pdtkelly/Explorer-HAT/RevA2/BOM/Explorer Board HAT Coupling Kit Rev A2 BOM.pdf

Item | Qty | Location (bottom ) | Mfg Part # | Description | Rating | Footprint | Mfg | Mouser | DigiKey | Notes | $ each | Total
| | | | Assemble Explorer HAT to Raspberry PI
1 | 4 | M1, M2, M3,M4 | 24423 | Hex Spacer M2.5 threaded Al 10mm | Keystone | NA | 36‐24423‐ND | 0.296 | 1.184
1 | | M1, M2, M3,M4 | 970090151 | Hex Spacer M2.5 threaded Al 9mm | Wurth | NA | 732‐10537‐ND | 0.422
3 | 8 | M1, M2, M3,M4 | 29300 | Screw Machine Pan M2.5 x 4mm | Keystone | 534‐29300 | 36‐29300‐ND | 0.237 | 1.896
5 | 0 | M1, M2, M3,M4 | 222 (Purple) | Threadlocker 222 tube 6 ml | Loctite | (on screw) | Amazon | 8.140 | 0.000

$3.08

1 | These components should be stocked due to concerns over lead time and/or limited substitutions available.
2 | Cut pins flush to this board (0.030 inch or less)
3 | Do not wash
4
5 | Leave holes open (do not fill with solder)
6 | Thru‐hole component
7

## Explorer Board HAT Coupling Kit PN: 1278 Rev A2

## As of: 10/26/2017 Patrick Kelly, Jack Kelly © Copyright 2017

Notes:

### Sub total:
