pdtkelly/Explorer-HAT/(threads)

Thread 11 (2019-01-01):

Drill holes.

kicker22004, 2019-01-01:
There is an issue in the Gerber files that don't allow the Drill holes to be detected by services like OSHPARK.
I've used this manufacture many times and had them correct the issue for me. Can you please look into this as it's a problem in the zwire_b.DRL file format.

This is a link to the corrected file format.
https://pastebin.com/JhBMNmCX
