pdtkelly/Explorer-HAT/RevA2/Schematic/Explorer Board HAT Rev A2 Schematic.pdf

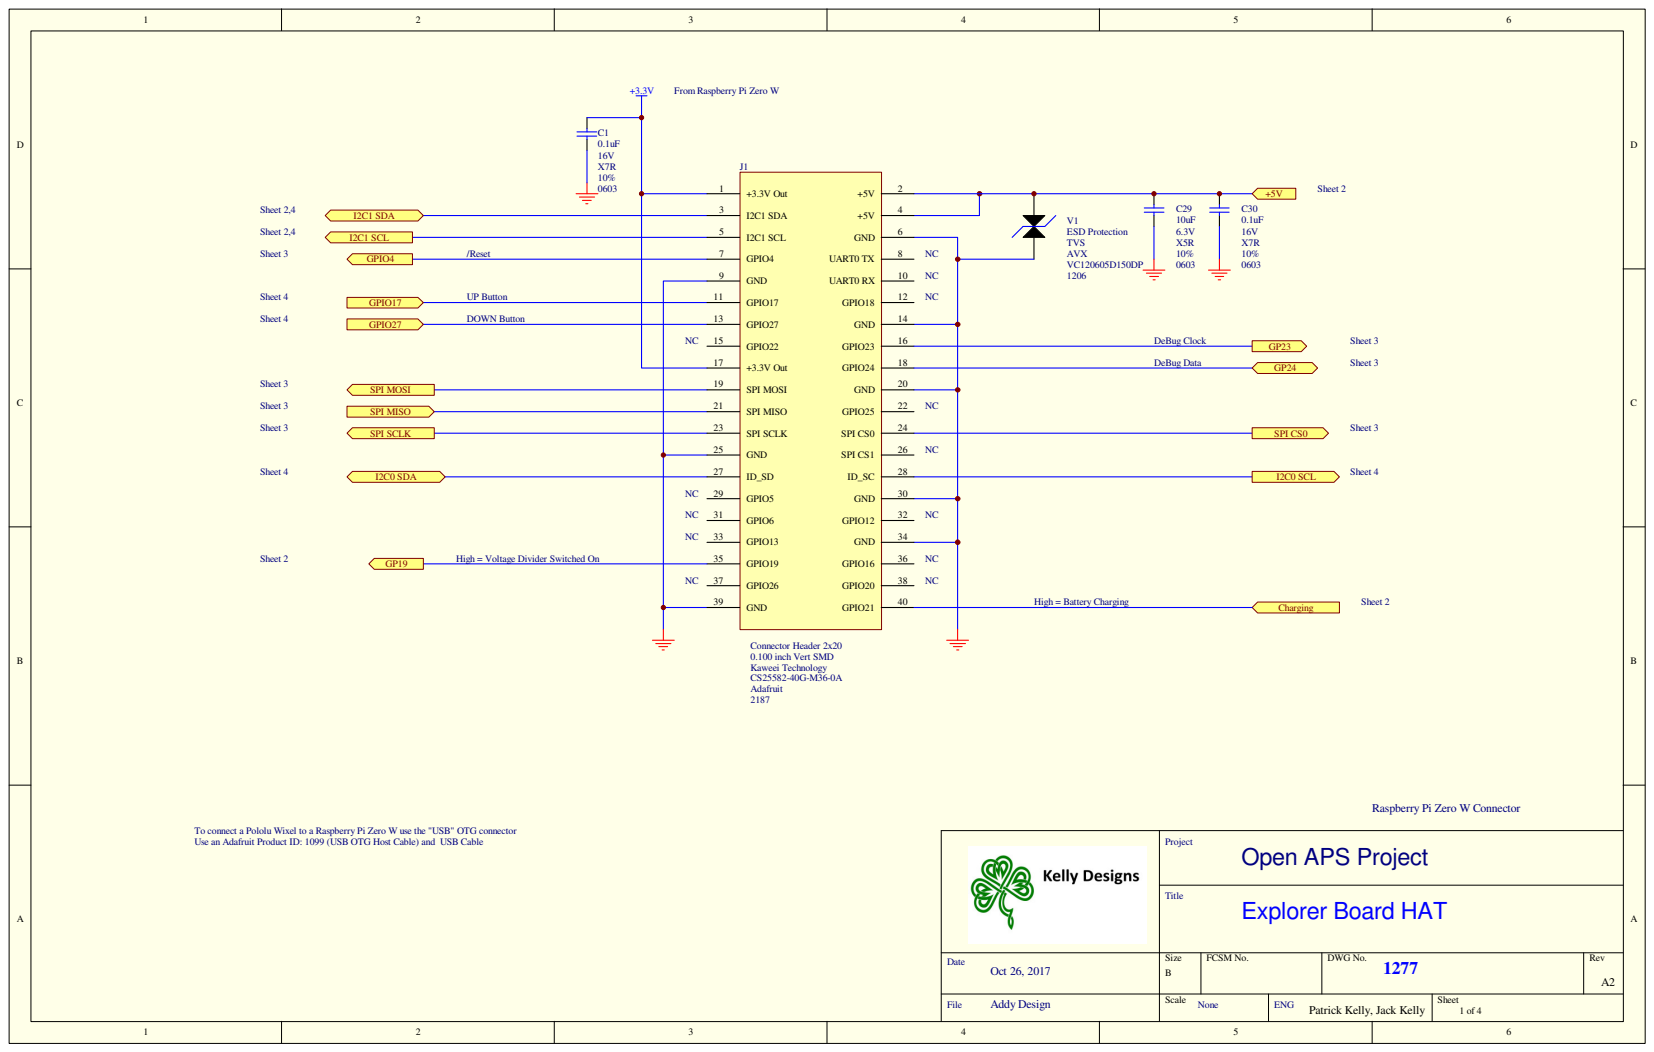
[picture p31: page 1]
Scale; Sheet; Size; FCSM No.; DWG No.; Rev; None; ENG; Project; Title; Date; File; Oct 26, 2017; Addy Design; Connector Header 2x20 0.100 inch Vert SMD Kaweei Technology CS25582-40G-M36-0A; From Raspberry Pi Zero W; I2C1 SDA; I2C1 SCL; Sheet 2; Sheet 2,4; GPIO4; GPIO17; GPIO27; SPI MOSI; SPI MISO; SPI SCLK; SPI CS0; Sheet 3; Sheet 4; I2C0 SDA; I2C0 SCL Sheet 4; +3.3V Out 1; I2C1 SDA 3; I2C1 SCL 5; GND; GPIO4 7; UART0 TX; GND 9; UART0 RX; GPIO17 11; GPIO18; GPIO27 13; GPIO22 15; GPIO23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

Raspberry Pi Zero W Connector

To connect a Pololu Wixel to a Raspberry Pi Zero W use the "USB" OTG connector
Use an Adafruit Product ID: 1099 (USB OTG Host Cable) and USB Cable

Open APS Project

Explorer Board HAT

Patrick Kelly, Jack Kelly

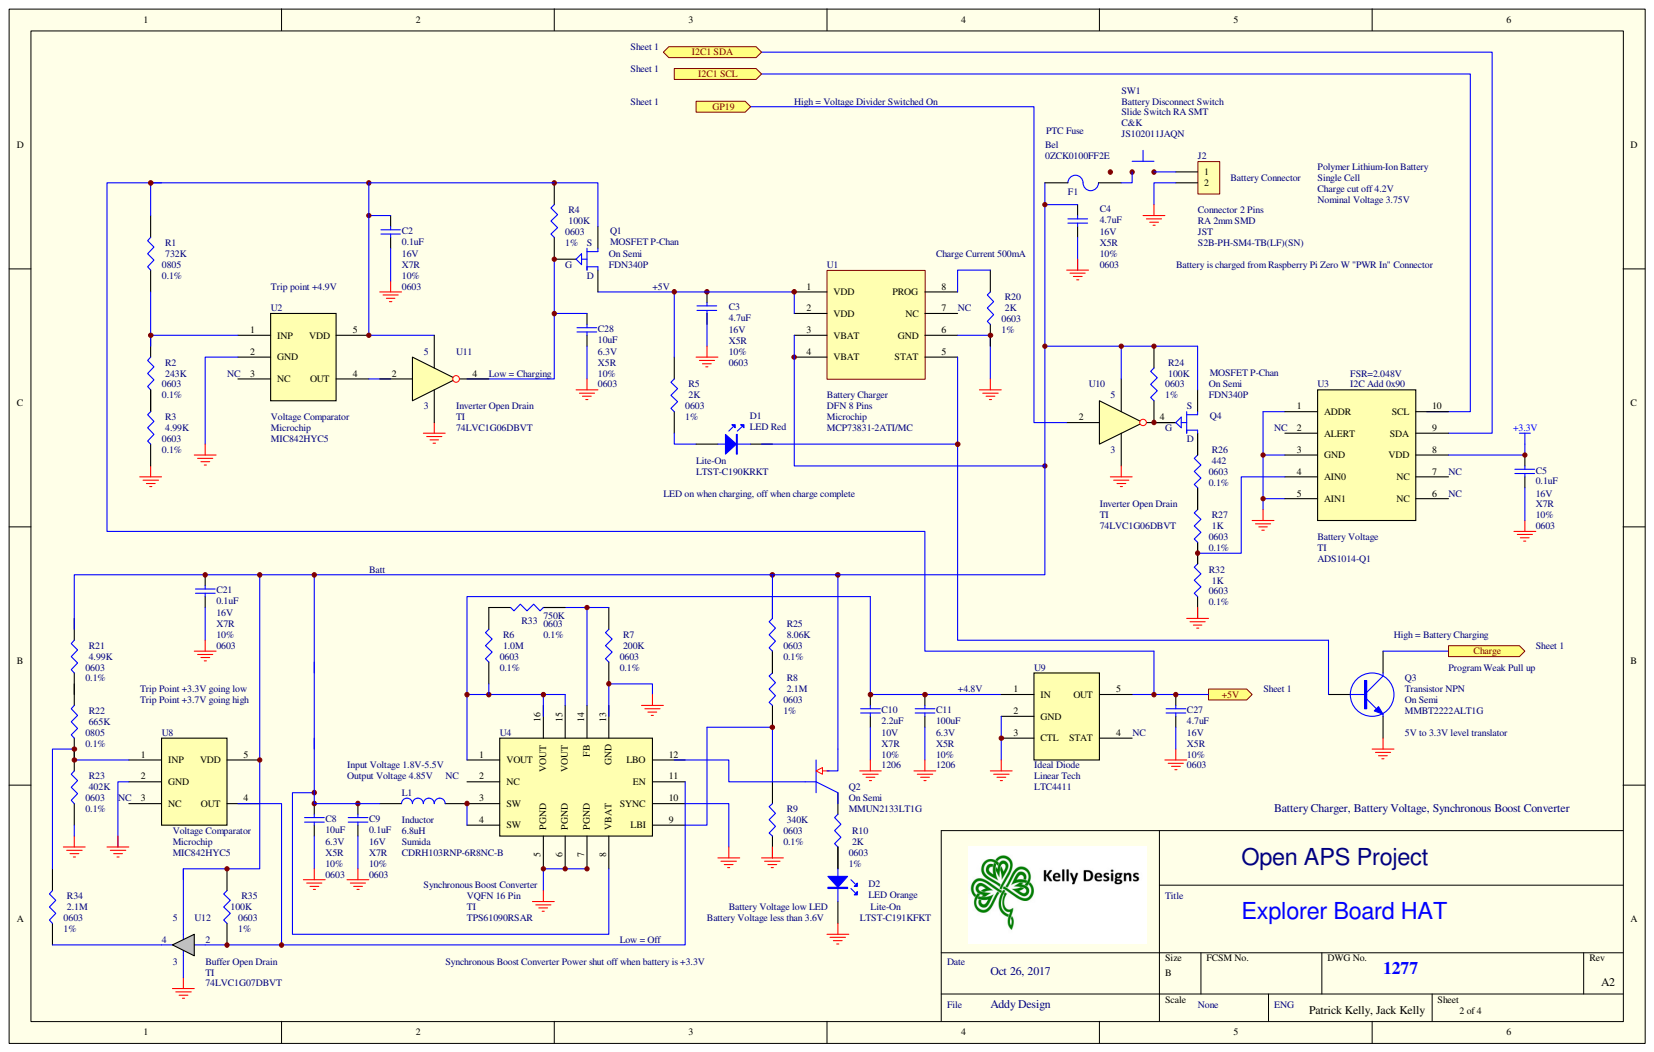
[picture p32: page 2]

High = Voltage Divider Switched On

Polymer Lithium-Ion Battery
Single Cell
Charge cut off 4.2V
Nominal Voltage 3.75V

Connector 2 Pins
RA 2mm SMD
JST

LED on when charging, off when charge complete

Program Weak Pull up

Trip Point +3.3V going low
Trip Point +3.7V going high

Battery Charger, Battery Voltage, Synchronous Boost Converter

Battery Voltage low LED
Battery Voltage less than 3.6V

Synchronous Boost Converter Power shut off when battery is +3.3V

Patrick Kelly, Jack Kelly

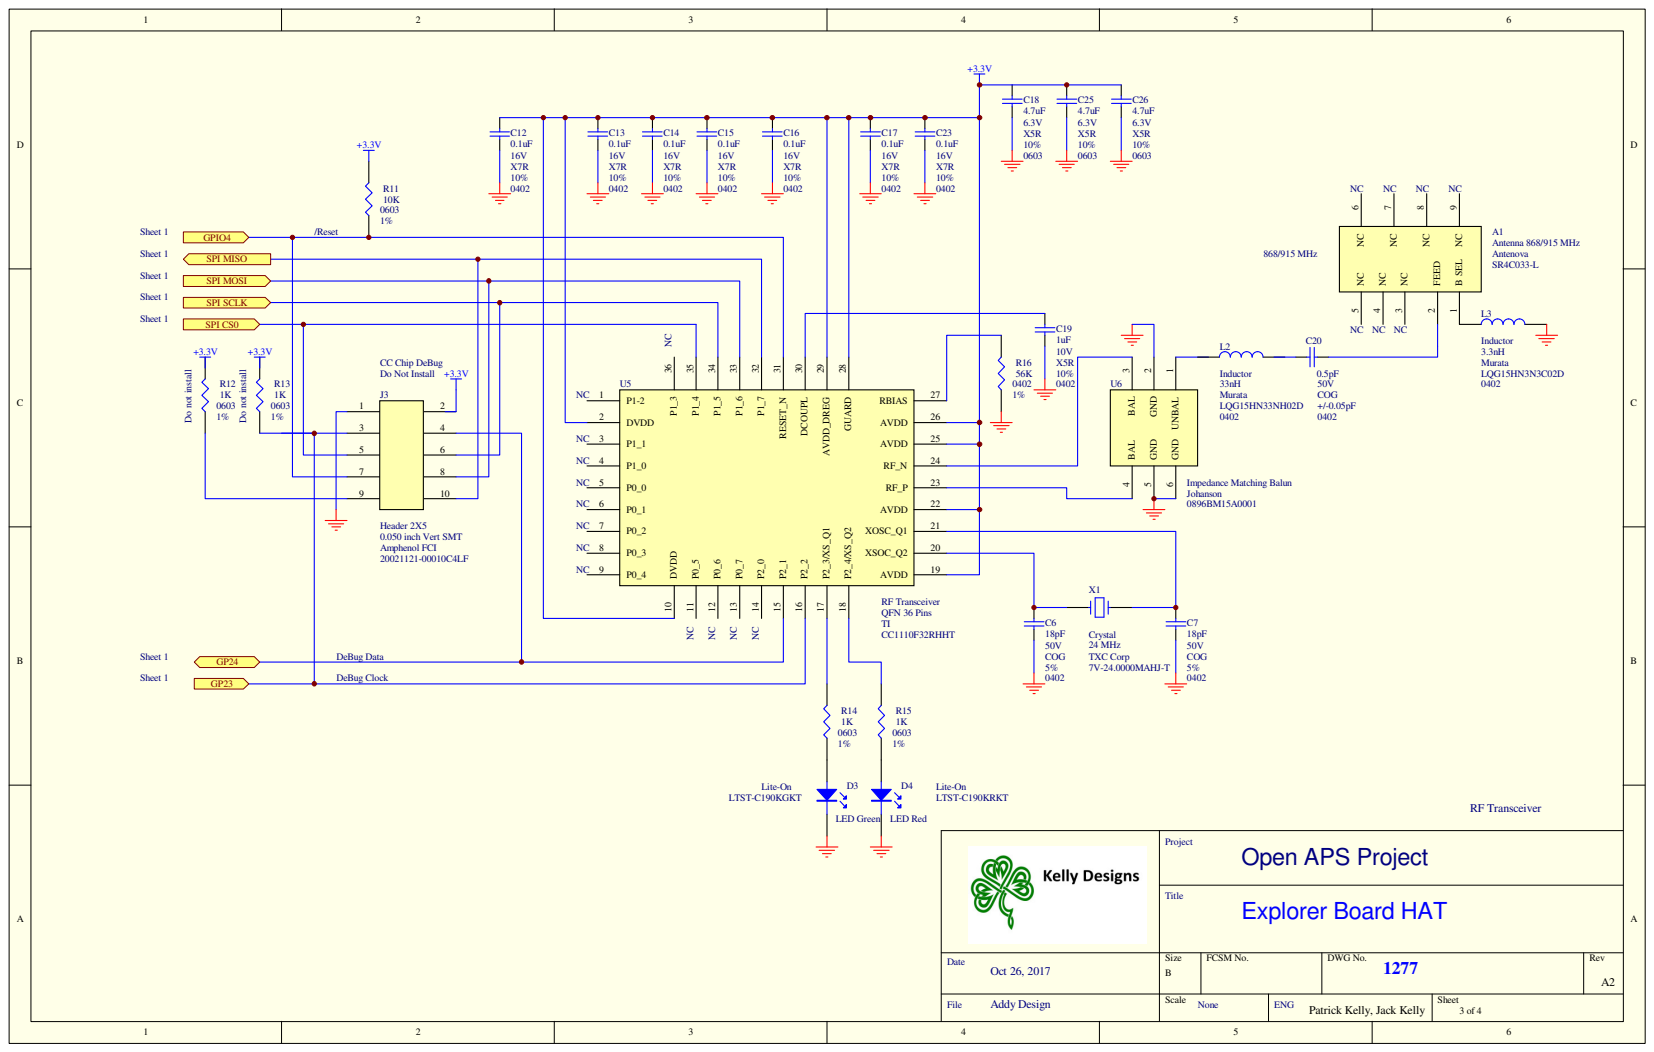
[picture p33: page 3]

Patrick Kelly, Jack Kelly

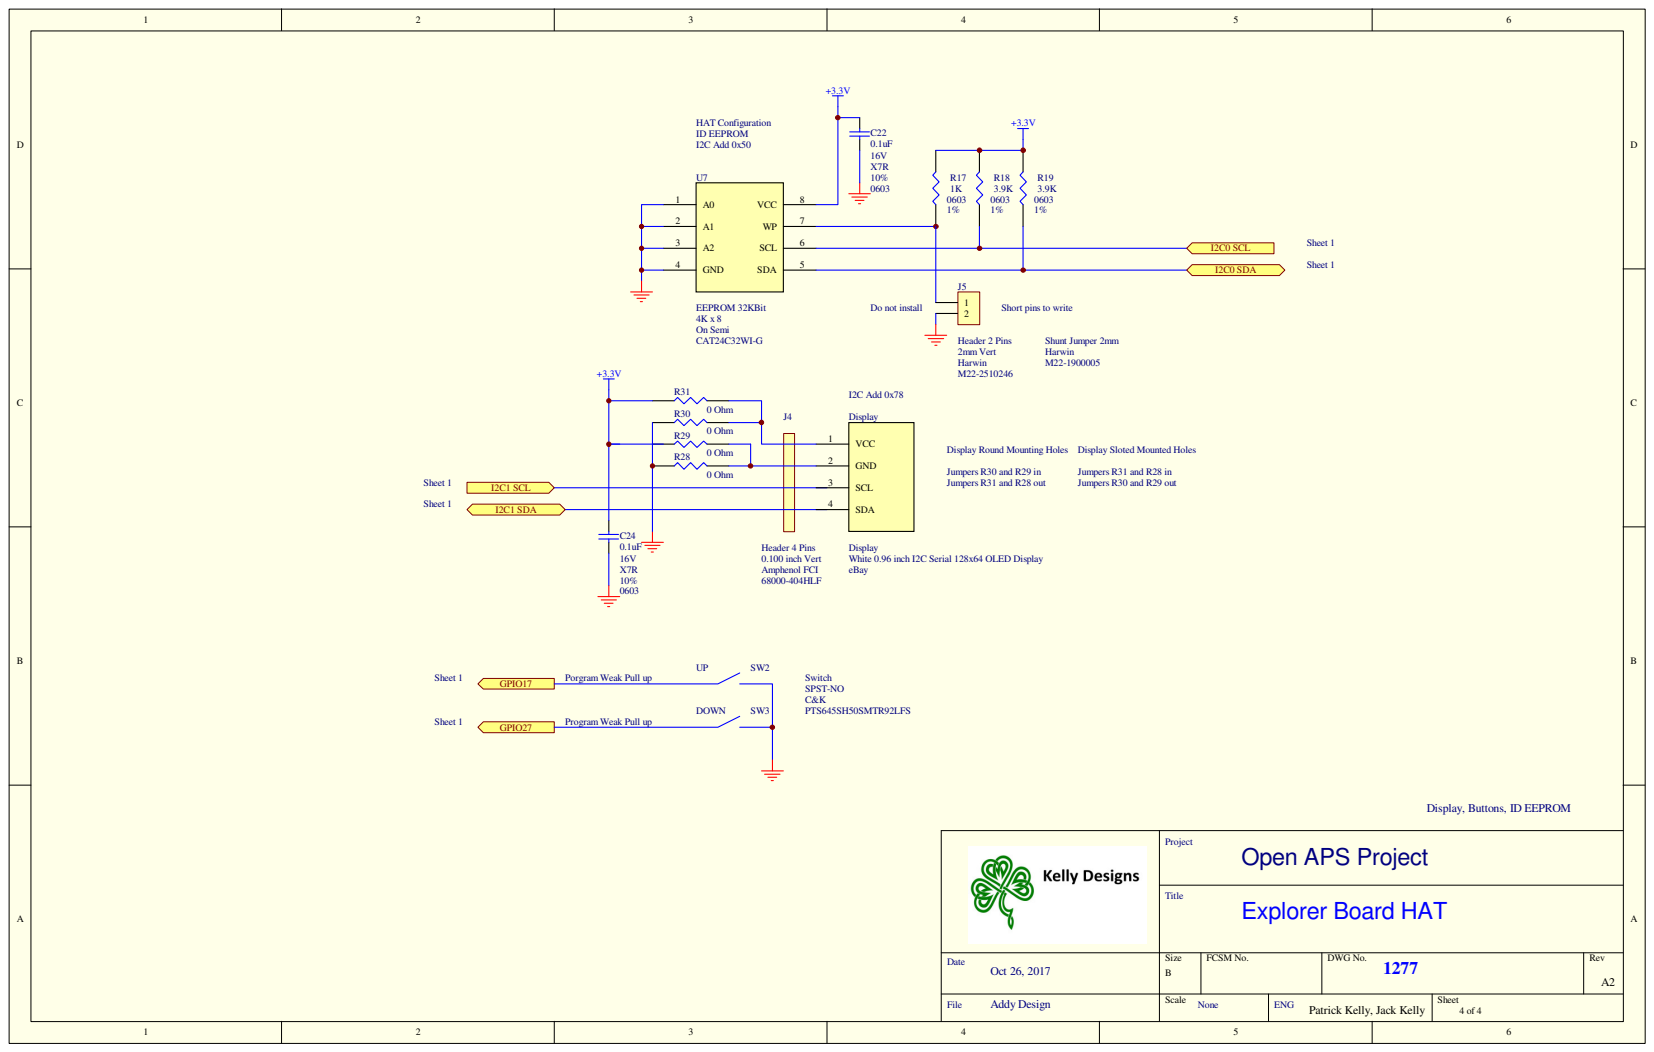
[picture p34: page 4]

Short pins to write

Display Round Mounting Holes Display Sloted Mounted Holes

Display
White 0.96 inch I2C Serial 128x64 OLED Display
eBay

Porgram Weak Pull up

Program Weak Pull up

Display, Buttons, ID EEPROM

Patrick Kelly, Jack Kelly
