pdtkelly/Explorer-HAT/Rev B/FAB/Explorer Board HAT Rev B FAB.pdf

D
D

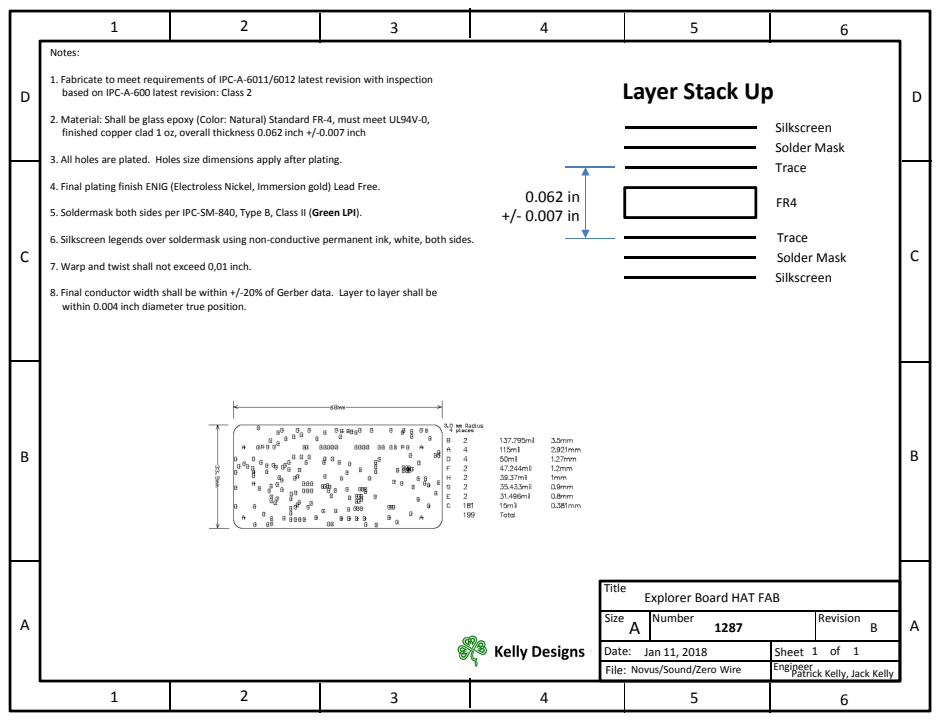
[picture p43: page 1]
Size; Number; Revision; Date:; File:; Sheet; Engineer; Jan 11, 2018; Novus/Sound/Zero Wire; Patrick Kelly, Jack Kelly; Notes:; Trace; Solder Mask; Silkscreen; Trace Solder Mask

1. Fabricate to meet requirements of IPC‐A‐6011/6012 latest revision with inspection
based on IPC‐A‐600 latest revision: Class 2

Layer Stack Up

2. Material: Shall be glass epoxy (Color: Natural) Standard FR‐4, must meet UL94V‐0,
finished copper clad 1 oz, overall thickness 0.062 inch +/‐0.007 inch

3. All holes are plated. Holes size dimensions apply after plating.

4. Final plating finish ENIG (Electroless Nickel, Immersion gold) Lead Free.

5. Soldermask both sides per IPC‐SM‐840, Type B, Class II (Green LPI).

6. Silkscreen legends over soldermask using non‐conductive permanent ink, white, both sides.
7. Warp and twist shall not exceed 0,01 inch.

8. Final conductor width shall be within +/‐20% of Gerber data. Layer to layer shall be
within 0.004 inch diameter true position.

Title
Explorer Board HAT FAB

A This document is confidential and proprietary to West Call and can not

be used in whole or part without
written consent of West Call.
