pdtkelly/Explorer-HAT/Rev B/Assembly/Bottom Assembly.pdf

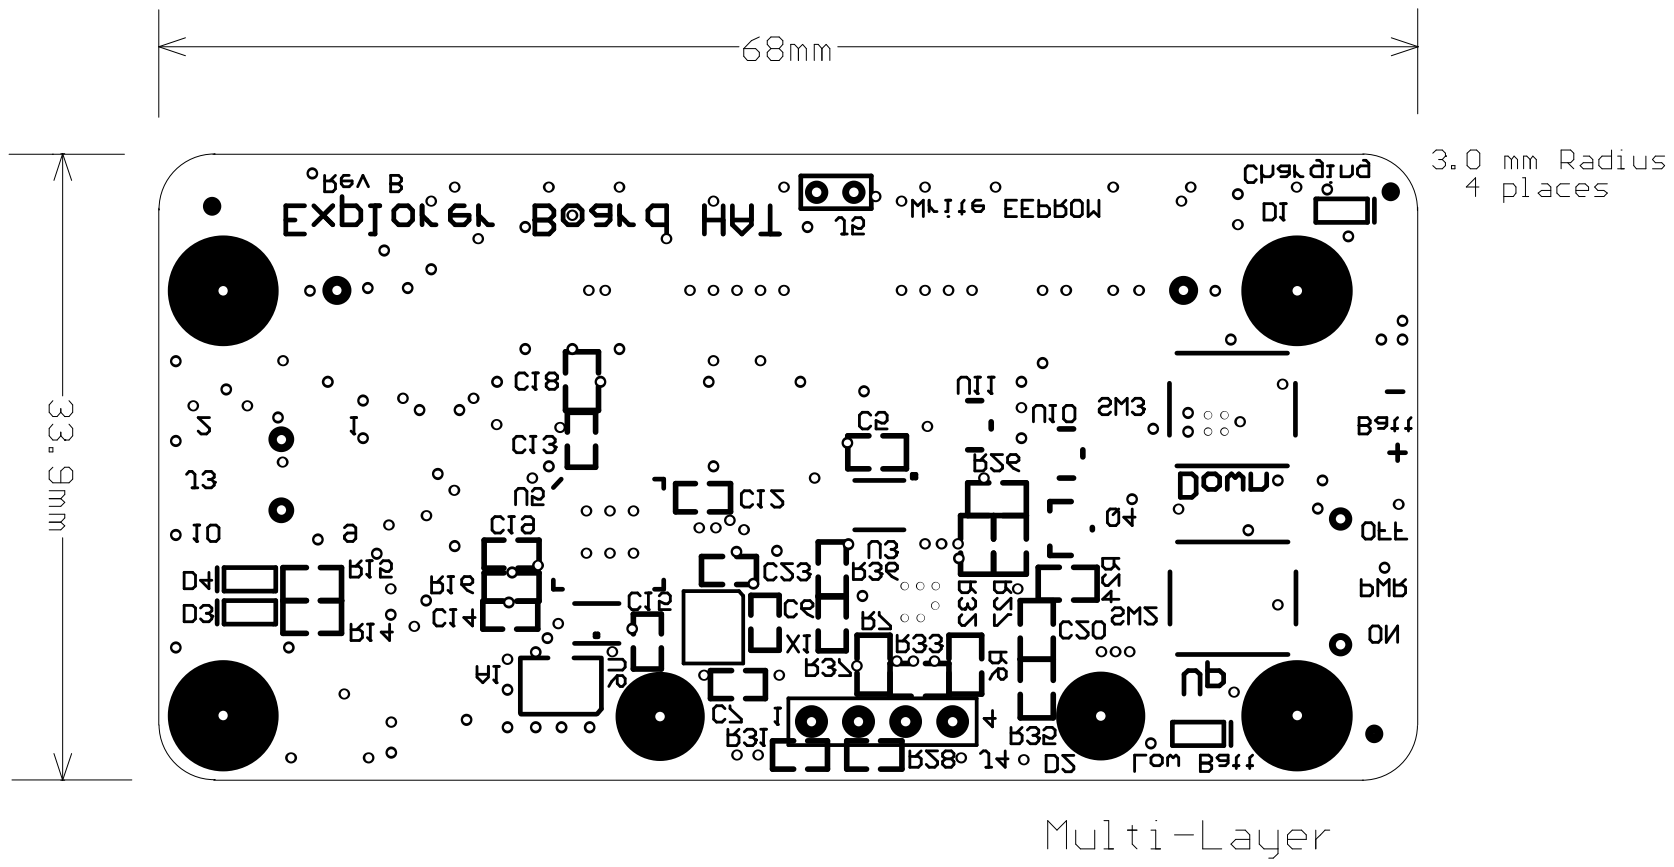
[picture p44: page 1]
