pdtkelly/Explorer-HAT/Rev B/Assembly/Top Assembly.pdf

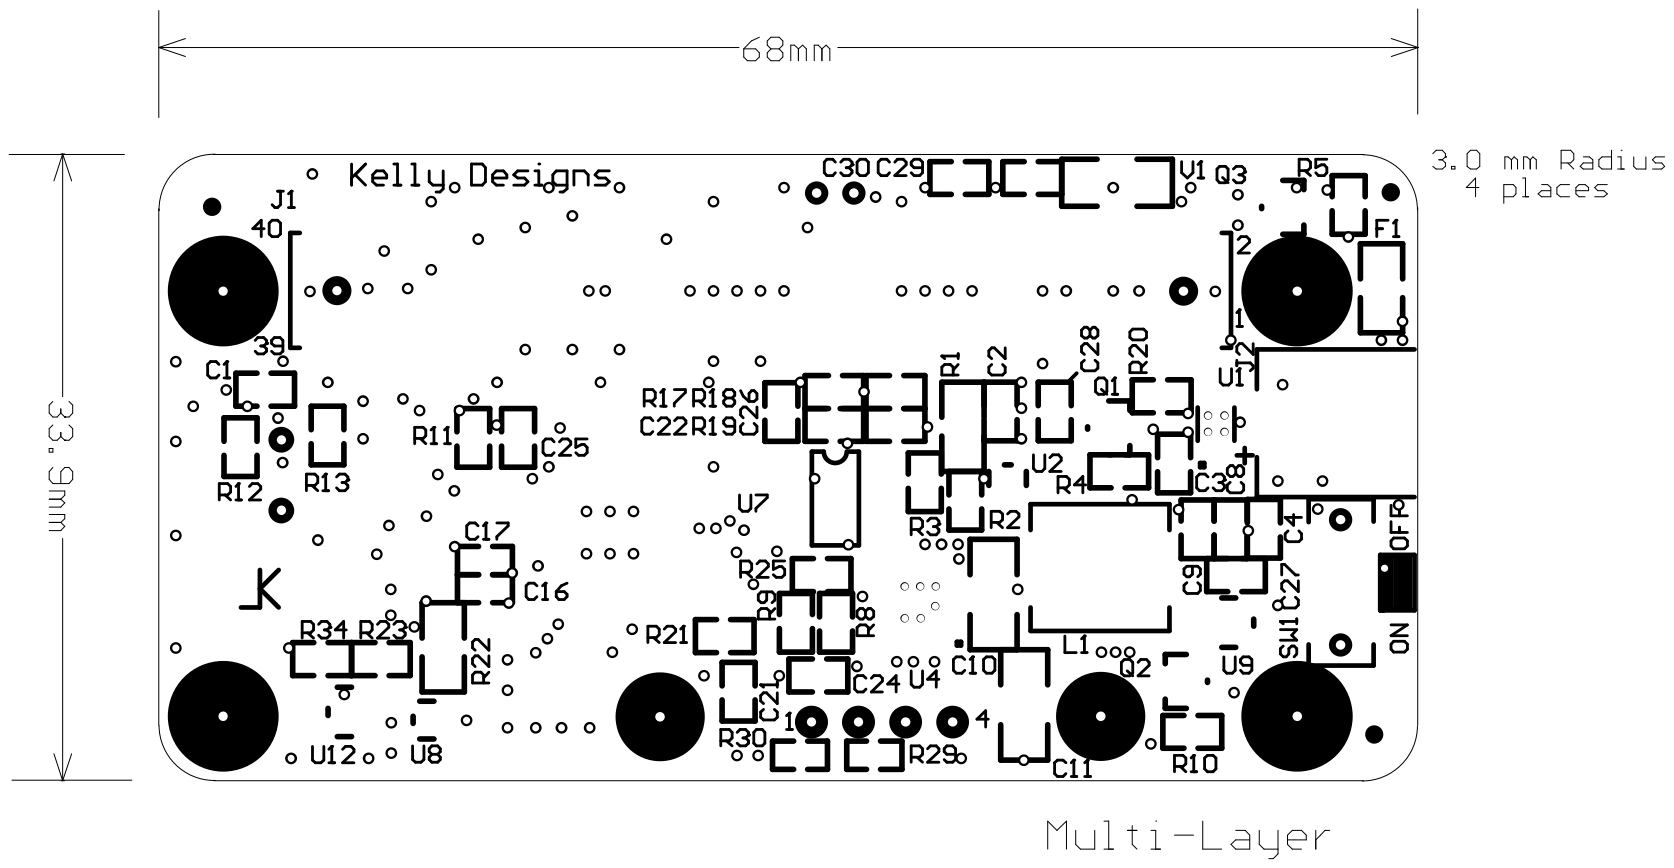
[picture p45: page 1]
