pdtkelly/Explorer-HAT/RevP1/fab/Exp HAT Bottom Layer.pdf

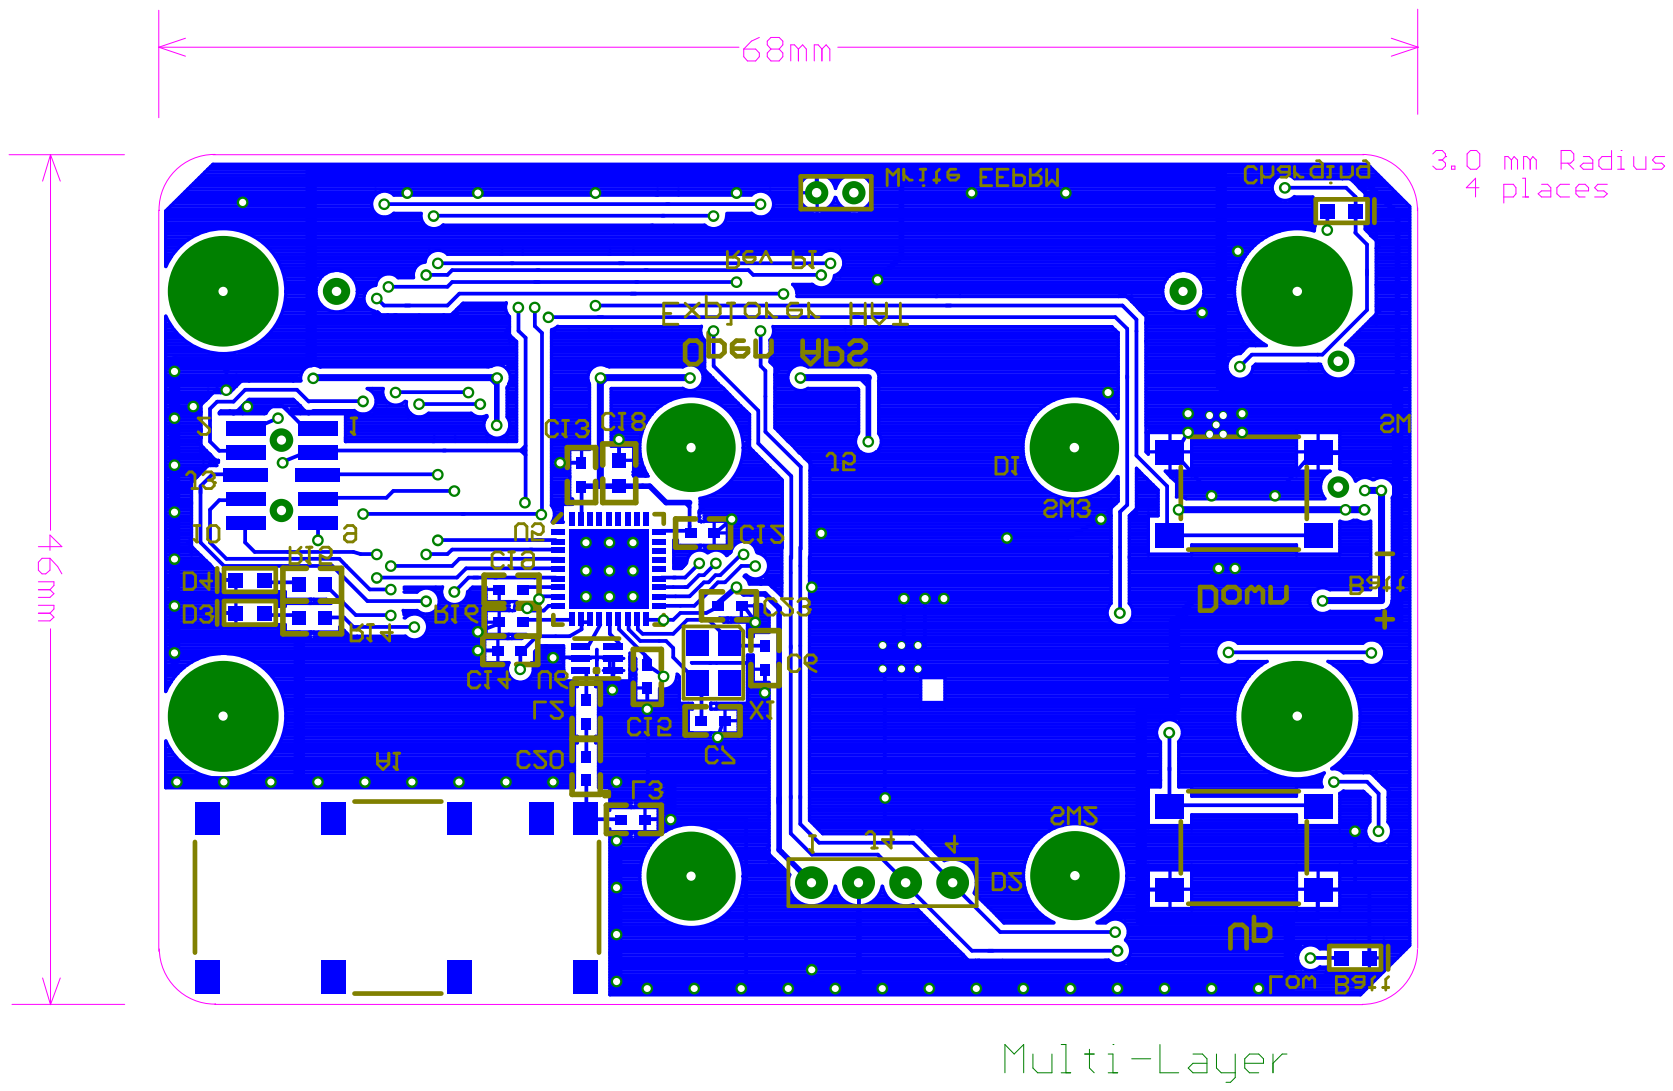
[picture p46: page 1]
