pdtkelly/Explorer-HAT/RevP1/fab/Exp HAT Comp Bottom.pdf

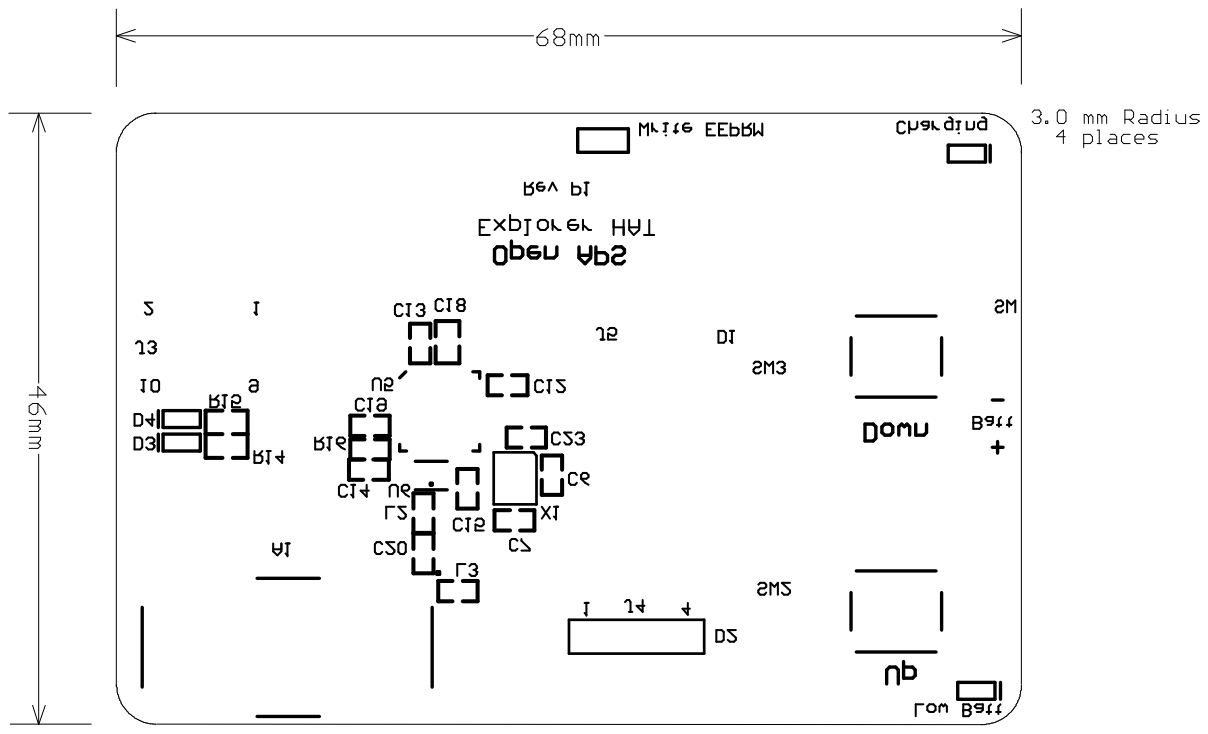
[picture p47: page 1]
