pdtkelly/Explorer-HAT/RevP1/fab/Exp HAT Comp Top.pdf

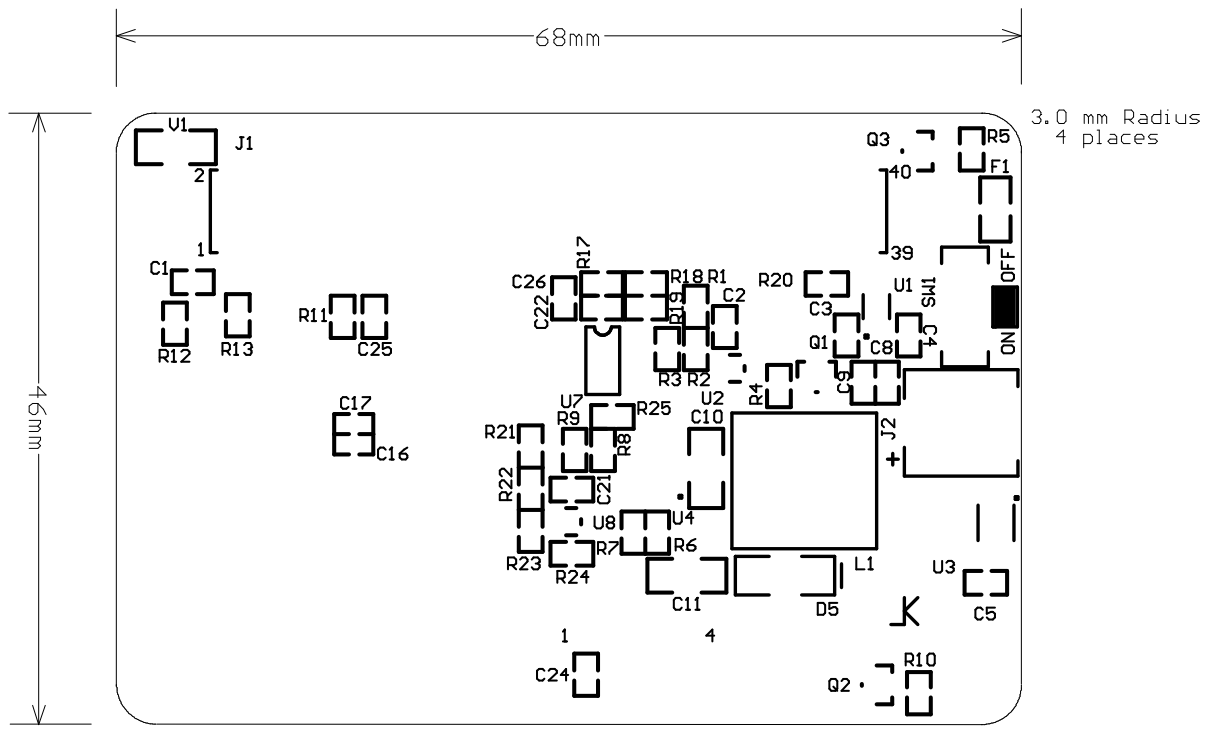
[picture p48: page 1]
