pdtkelly/Explorer-HAT/RevP1/fab/Exp HAT Top Layer.pdf

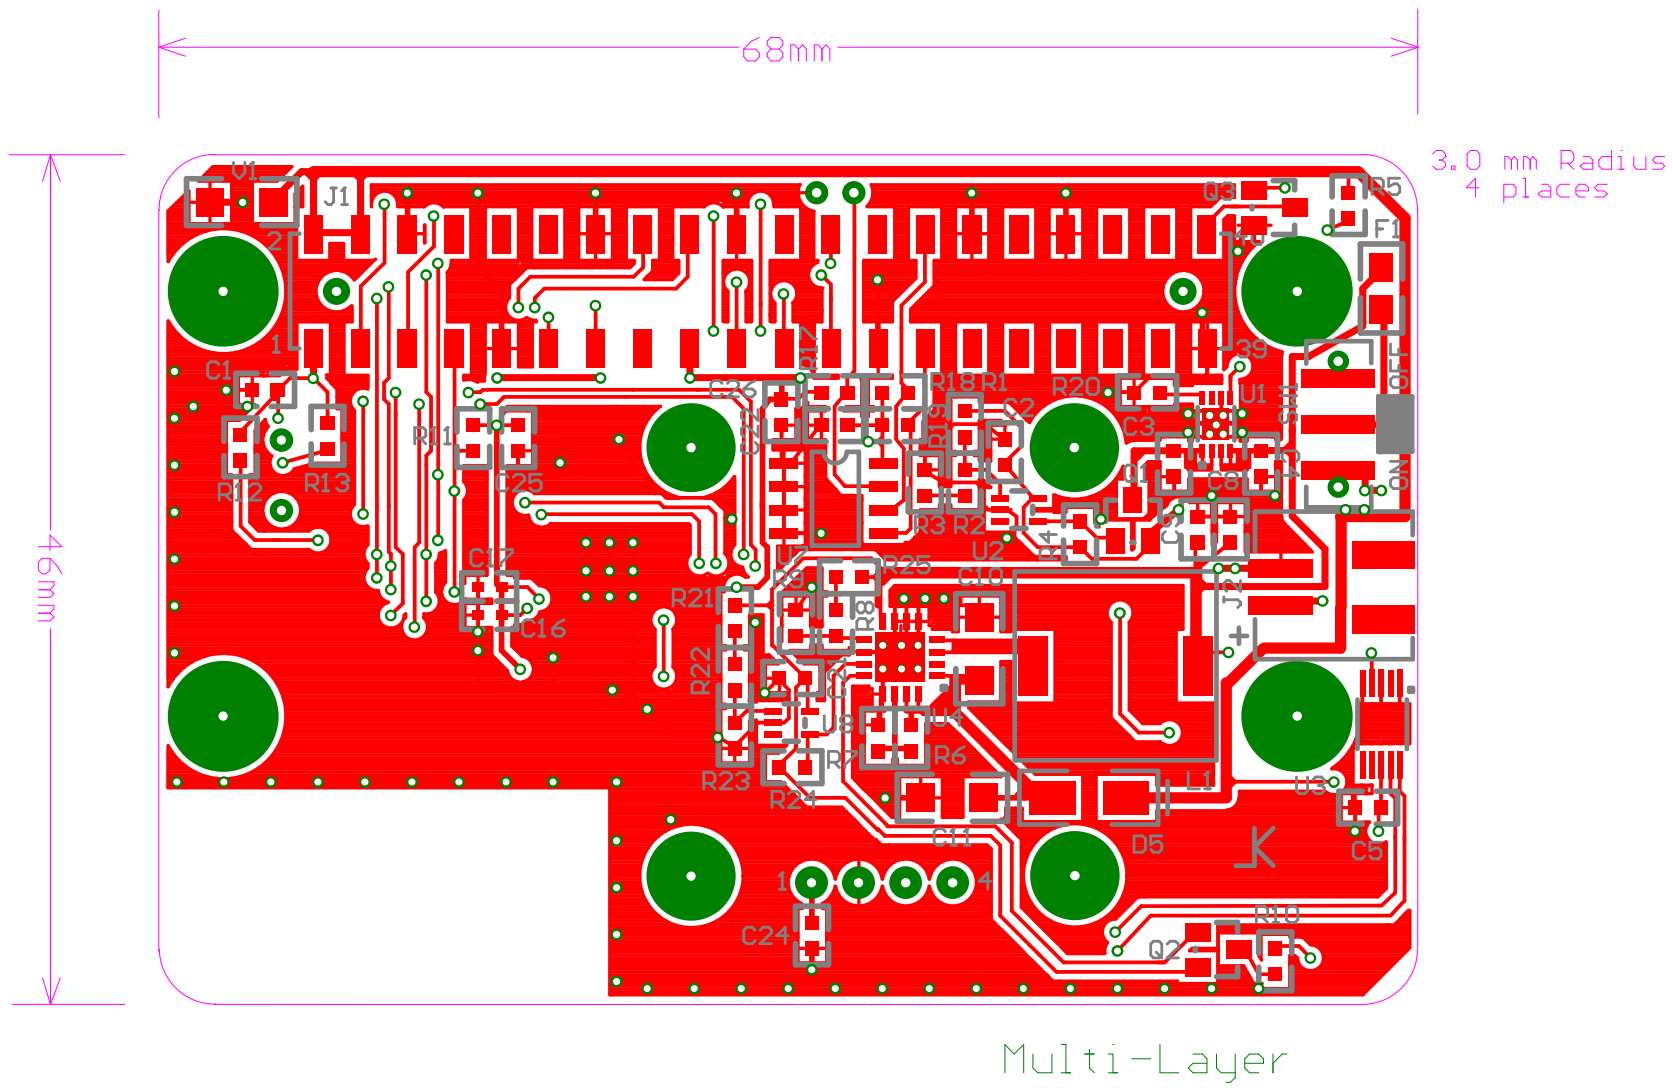
[picture p49: page 1]
