pdtkelly/Explorer-HAT/RevP3/Assembly/Bottom Assembly.pdf

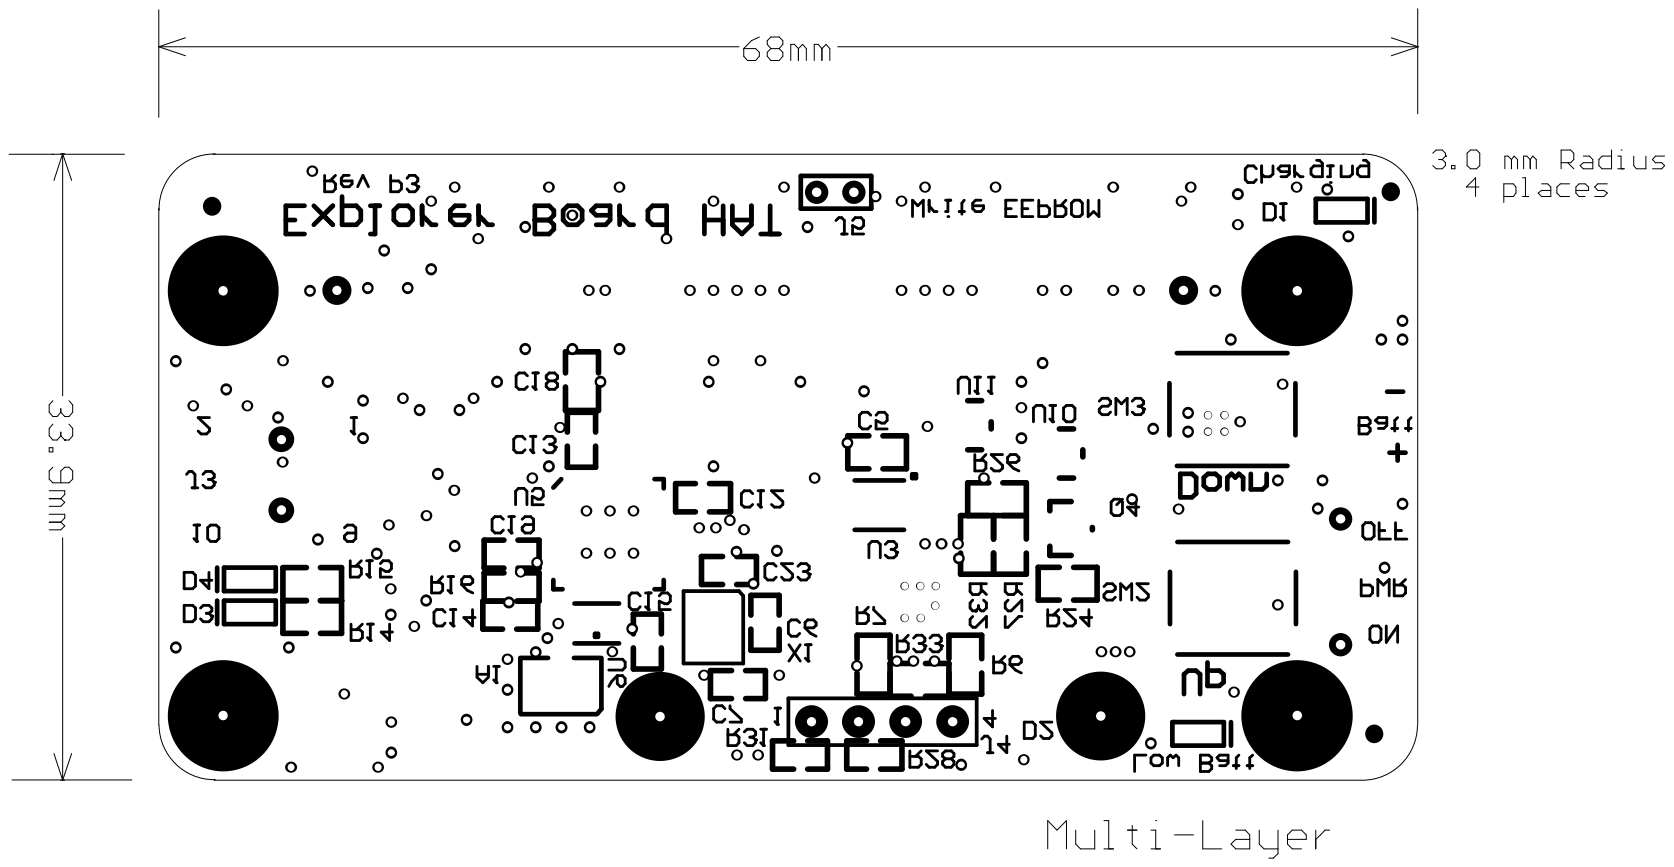
[picture p54: page 1]
