pdtkelly/Explorer-HAT/RevP3/Assembly/Top Assembly.pdf

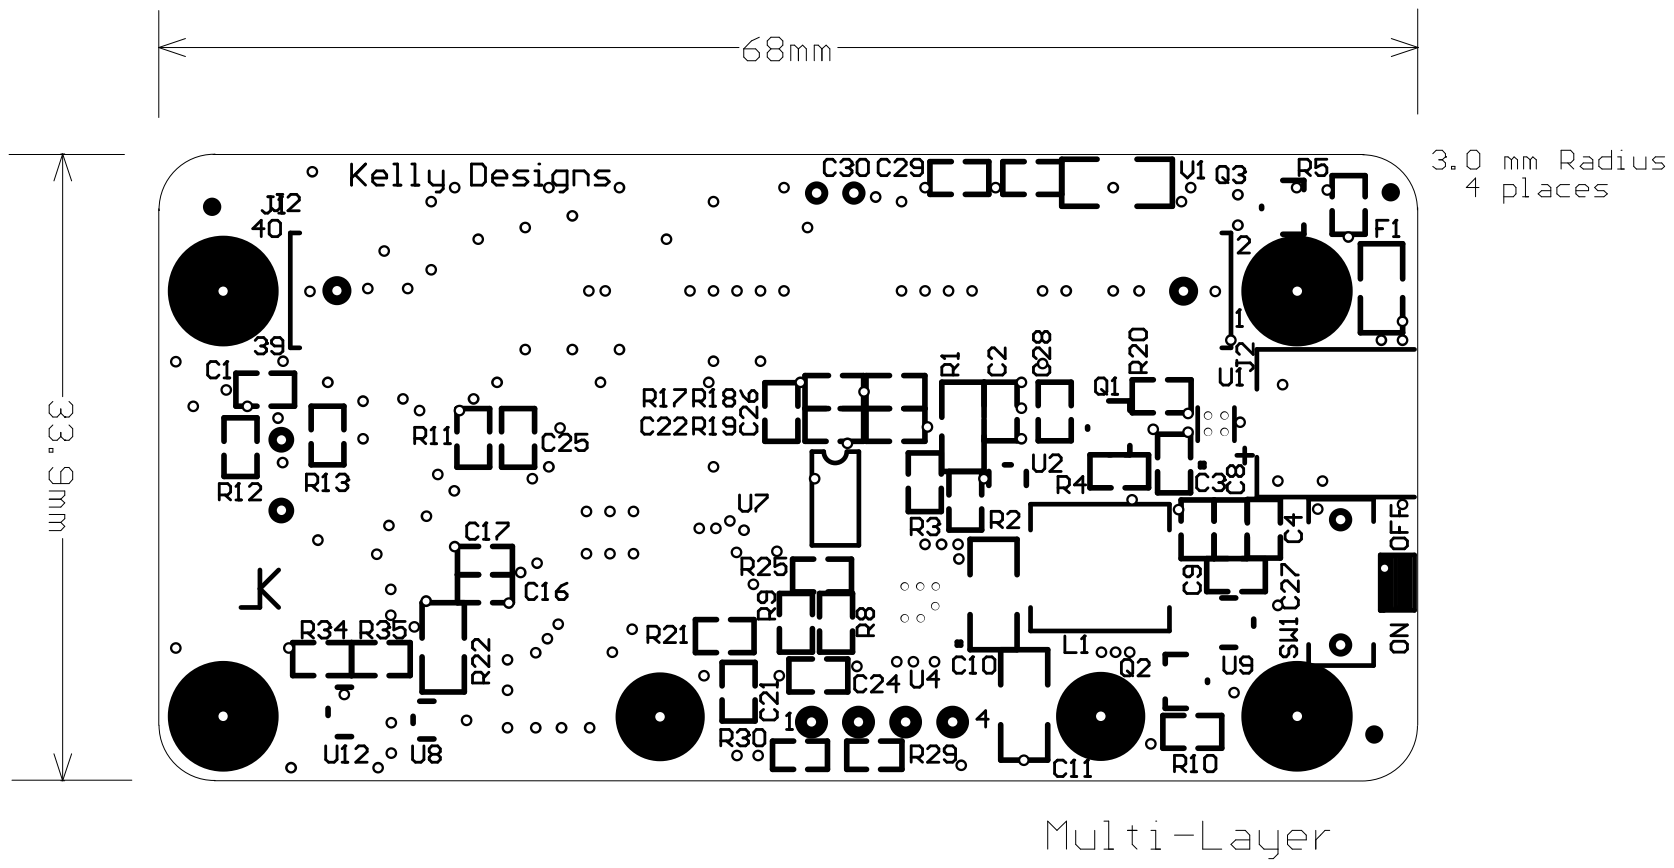
[picture p55: page 1]
