pdtkelly/Explorer-HAT/RevA2/Assembly/Bottom Assembly.pdf

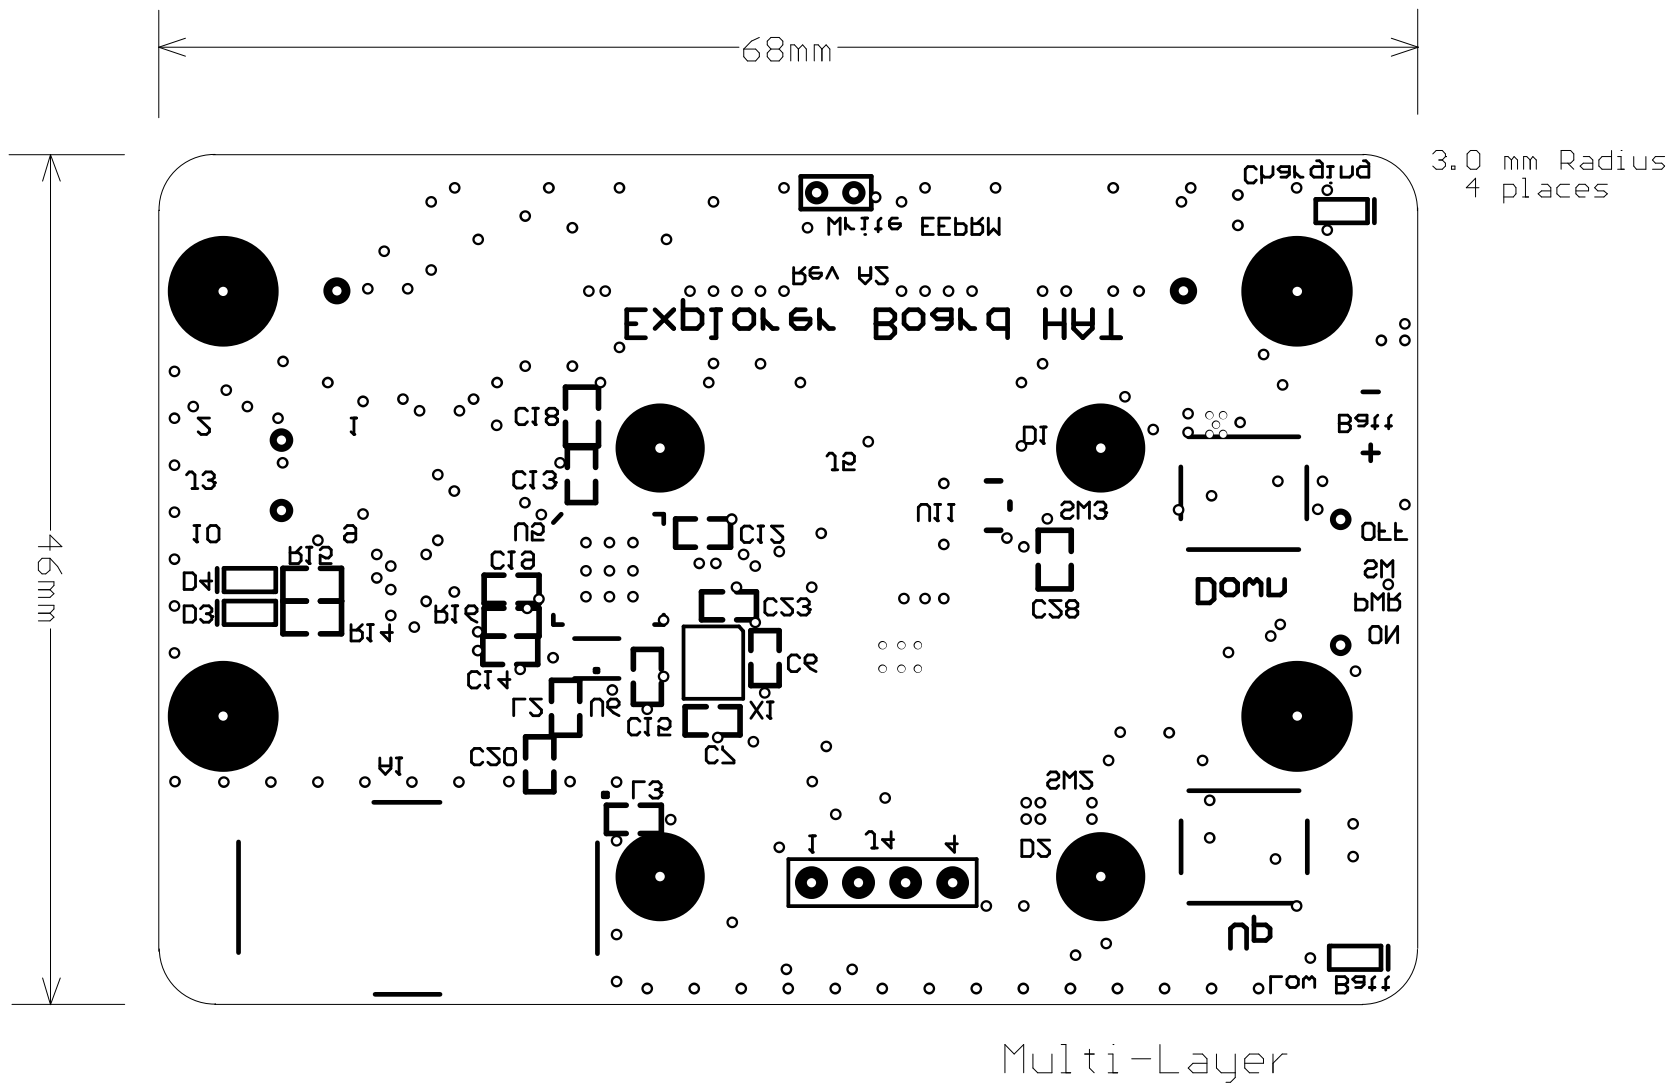
[picture p56: page 1]
