pdtkelly/Explorer-HAT/RevA2/Assembly/Top Assembly.pdf

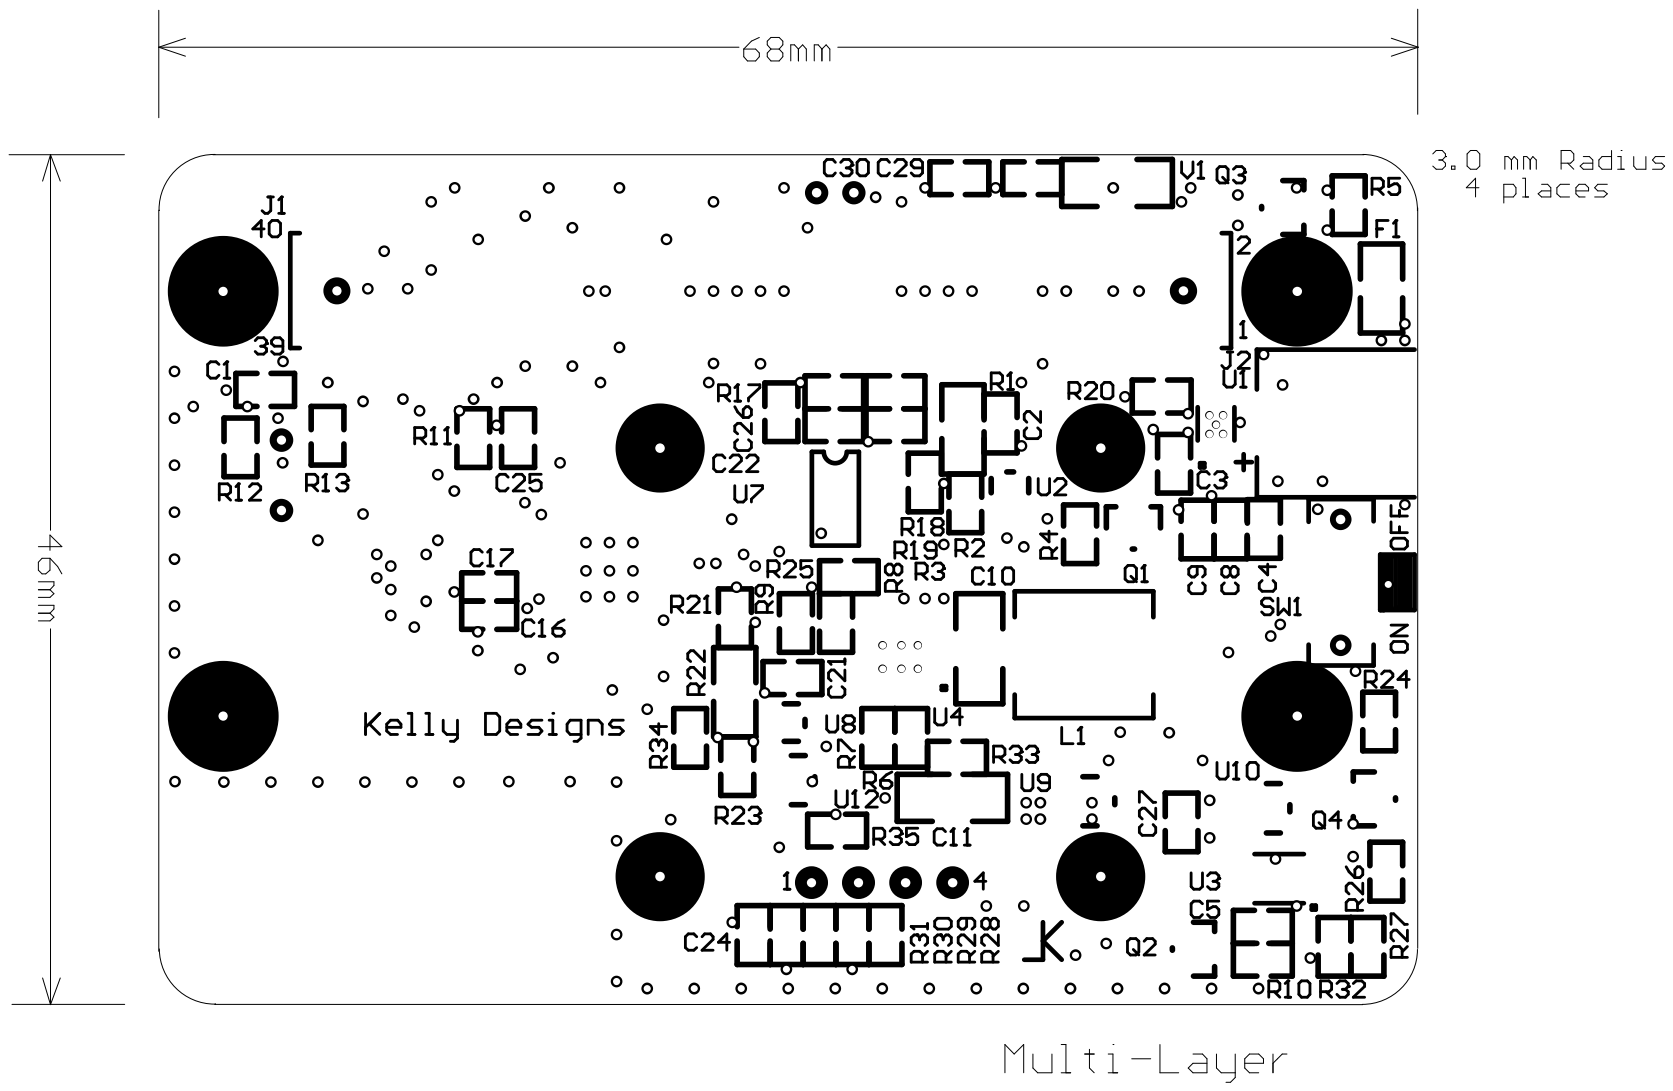
[picture p57: page 1]
