pdtkelly/Explorer-HAT/(commit log)

2017-10-12 Moved board files into version folder. Added new RevA board files.
    [zero_a.DRL, zero_a.GBL, zero_a.GBO, zero_a.GBP, zero_a.GBS, zero_a.GM1, zero_a.GTL, zero_a.GTO]
2017-10-20 Added RevA1 files.
    [zero_a1.DRL, zero_a1.GBL, zero_a1.GBO, zero_a1.GBP, zero_a1.GBS, zero_a1.GM1, zero_a1.GTL, zero_a1.GTO]
2017-12-01 Removed chip antenna, replaced with wired antenna, reduced size of PCB.
2018-01-19 Added assembly instructions.
2018-06-01 Fixed charging LED that stays on after charge completes.
2018-06-04 Fixed charging LED that stays on after charge completes (updated).
